ze-or/Taiplit20/README.md

# Taiplit20
20 key wireless split ergonomic keyboard
