ze-or/Taiplit20/PCB/PCB-Right/PCB-Right.kicad_pcb

## KiCad design PCB/PCB-Right/PCB-Right.kicad_pcb (2026-09-20)

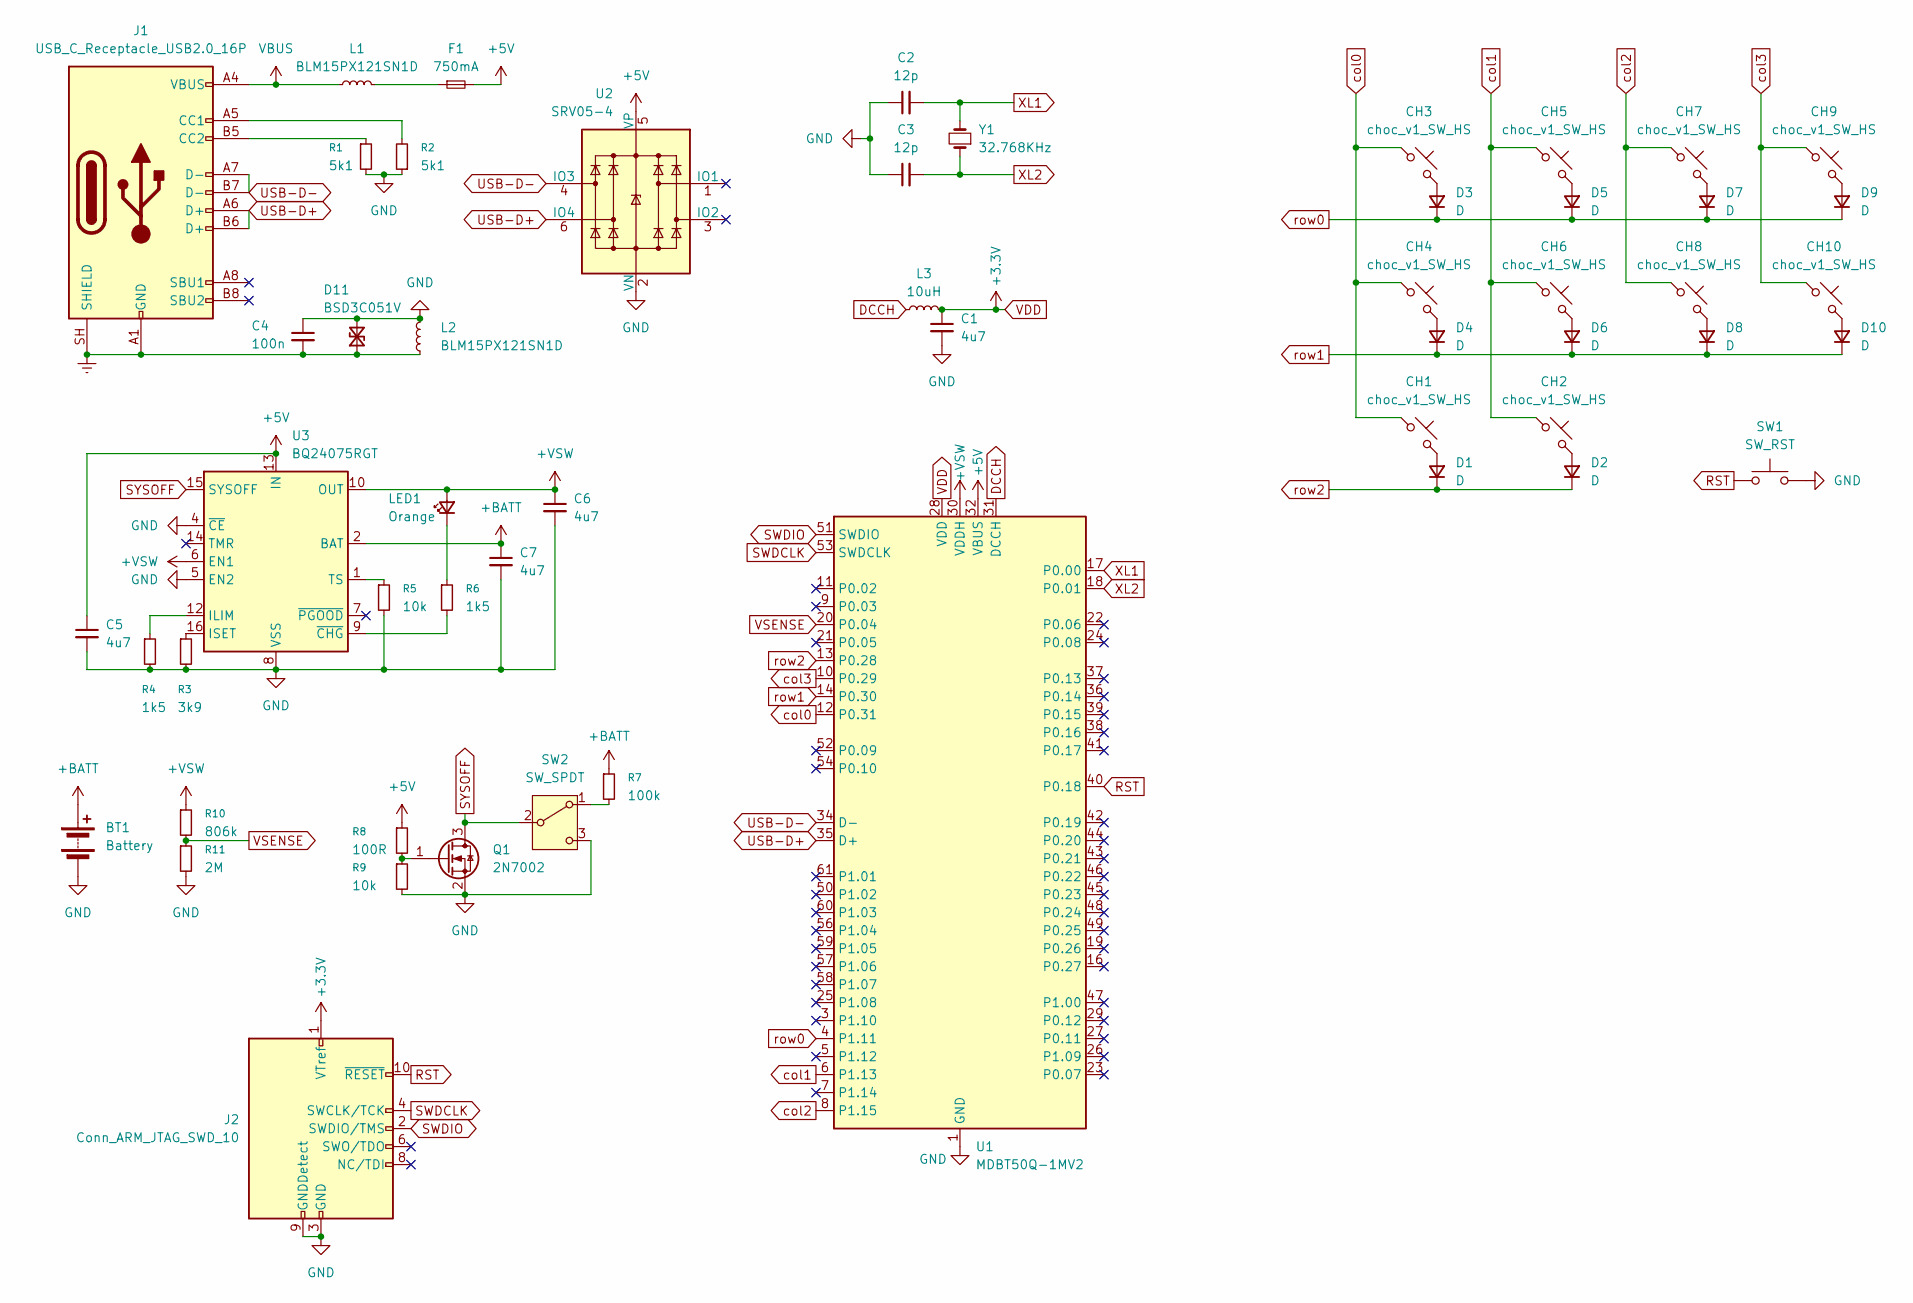
[picture p1: schematic PCB-Right.kicad_sch]

Parts:
BT1: Battery; JST_ACH_BM02B-ACHSS-GAN-ETF_1x02-1MP_P1.20mm_Vertical
C1, C5, C6, C7: 4u7; C_0603_1608Metric
C2, C3: 12p; C_0603_1608Metric
C4: 100n; C_0603_1608Metric
CH1, CH2, CH3, CH4, CH5, CH6, CH7, CH8, CH9, CH10: choc_v1_SW_HS; SW_choc_v2_HS_CPG135001S30_1u
D1, D2, D3, D4, D5, D6, D7, D8, D9, D10: D; D_SOD-123
D11: BSD3C051V; D_SOD-323
F1: 750mA; Fuse_1206_3216Metric
J1: USB_C_Receptacle_USB2.0_16P; USB_C_Receptacle_HRO_TYPE-C-31-M-12
J2: Conn_ARM_JTAG_SWD_10; PinHeader_2x05_P1.27mm_Vertical
L1, L2: BLM15PX121SN1D; L_0402_1005Metric
L3: 10uH; L_0603_1608Metric
LED1: Orange; LED_0805_2012Metric
Q1: 2N7002; SOT-23
R1, R2: 5k1; R_0603_1608Metric
R3: 3k9; R_0603_1608Metric
R4, R6: 1k5; R_0603_1608Metric
R5, R9: 10k; R_0603_1608Metric
R7: 100k; R_0603_1608Metric
R8: 100R; R_0603_1608Metric
R10: 806k; R_0603_1608Metric
R11: 2M; R_0603_1608Metric
SW1: SW_RST; SW_SPST_TL3342
SW2: SW_SPDT; SW_MSK12C02-HB
U1: MDBT50Q-1MV2; Raytac_MDBT50Q
U2: SRV05-4; SOT-23-6
U3: BQ24075RGT; VQFN-16-1EP_3x3mm_P0.5mm_EP1.6x1.6mm
Y1: 32.768KHz; Crystal_SMD_3215-2Pin_3.2x1.5mm

Connections:
+5V: C5.1, F1.2, R8.1, U1.32 (VBUS), U2.5 (VP), U3.13 (IN)
+BATT: BT1.1 (+), C7.1, R7.1, U3.2 (BAT), U3.3 (BAT)
+VSW: C6.1, LED1.2 (A), R10.1, U1.30 (VDDH), U3.6 (EN1), U3.10 (OUT), U3.11 (OUT)
DCCH: L3.1, U1.31 (DCCH)
Earth: C4.2, D11.1 (A1), J1.A1 (GND), J1.A12 (GND), J1.B1 (GND), J1.B12 (GND), J1.SH (SHIELD), L2.1
GND: BT1.2 (-), C1.2, C2.1, C3.1, C4.1, C5.2, C6.2, C7.2, D11.2 (A2), J2.3 (GND), J2.5 (GND), J2.9 (GNDDetect), L2.2, Q1.2 (S), R1.2, R2.1, R3.2, R4.2, R5.2, R9.2, R11.2, SW1.2, SW2.3 (C), U1.1 (GND), U1.2 (GND), U1.15 (GND), U1.33 (GND), U1.55 (GND), U2.2 (VN), U3.4 (~CE), U3.5 (EN2), U3.8 (VSS), U3.17 (VSS)
unnamed: CH1.2, D1.2 (A)
unnamed: CH2.2, D2.2 (A)
unnamed: CH3.2, D3.2 (A)
unnamed: CH4.2, D4.2 (A)
unnamed: CH5.2, D5.2 (A)
unnamed: CH6.2, D6.2 (A)
unnamed: CH7.2, D7.2 (A)
unnamed: CH8.2, D8.2 (A)
unnamed: CH9.2, D9.2 (A)
unnamed: CH10.2, D10.2 (A)
unnamed: F1.1, L1.2
unnamed: J1.A5 (CC1), R2.2
unnamed: J1.B5 (CC2), R1.1
unnamed: LED1.1 (K), R6.1
unnamed: Q1.1 (G), R8.2, R9.1
unnamed: R7.2, SW2.1 (A)
unnamed: R4.1, U3.12 (ILIM)
unnamed: R3.1, U3.16 (ISET)
unnamed: R5.1, U3.1 (TS)
unnamed: R6.2, U3.9 (~CHG)
RST: J2.10 (~RESET), SW1.1, U1.40 (P0.18)
SWDCLK: J2.4 (SWCLK/TCK), U1.53 (SWDCLK)
SWDIO: J2.2 (SWDIO/TMS), U1.51 (SWDIO)
SYSOFF: Q1.3 (D), SW2.2 (B), U3.15 (SYSOFF)
USB-D+: J1.A6 (D+), J1.B6 (D+), U1.35 (D+), U2.6 (IO4)
USB-D-: J1.A7 (D-), J1.B7 (D-), U1.34 (D-), U2.4 (IO3)
VBUS: J1.A4 (VBUS), J1.A9 (VBUS), J1.B4 (VBUS), J1.B9 (VBUS), L1.1
VDD: C1.1, J2.1 (VTref), L3.2, U1.28 (VDD)
VSENSE: R10.2, R11.1, U1.20 (P0.04)
XL1: C2.2, U1.17 (P0.00), Y1.2
XL2: C3.2, U1.18 (P0.01), Y1.1
col0: CH1.1, CH3.1, CH4.1, U1.12 (P0.31)
col1: CH2.1, CH5.1, CH6.1, U1.6 (P1.13)
col2: CH7.1, CH8.1, U1.8 (P1.15)
col3: CH9.1, CH10.1, U1.10 (P0.29)
row0: D3.1 (K), D5.1 (K), D7.1 (K), D9.1 (K), U1.4 (P1.11)
row1: D4.1 (K), D6.1 (K), D8.1 (K), D10.1 (K), U1.14 (P0.30)
row2: D1.1 (K), D2.1 (K), U1.13 (P0.28)

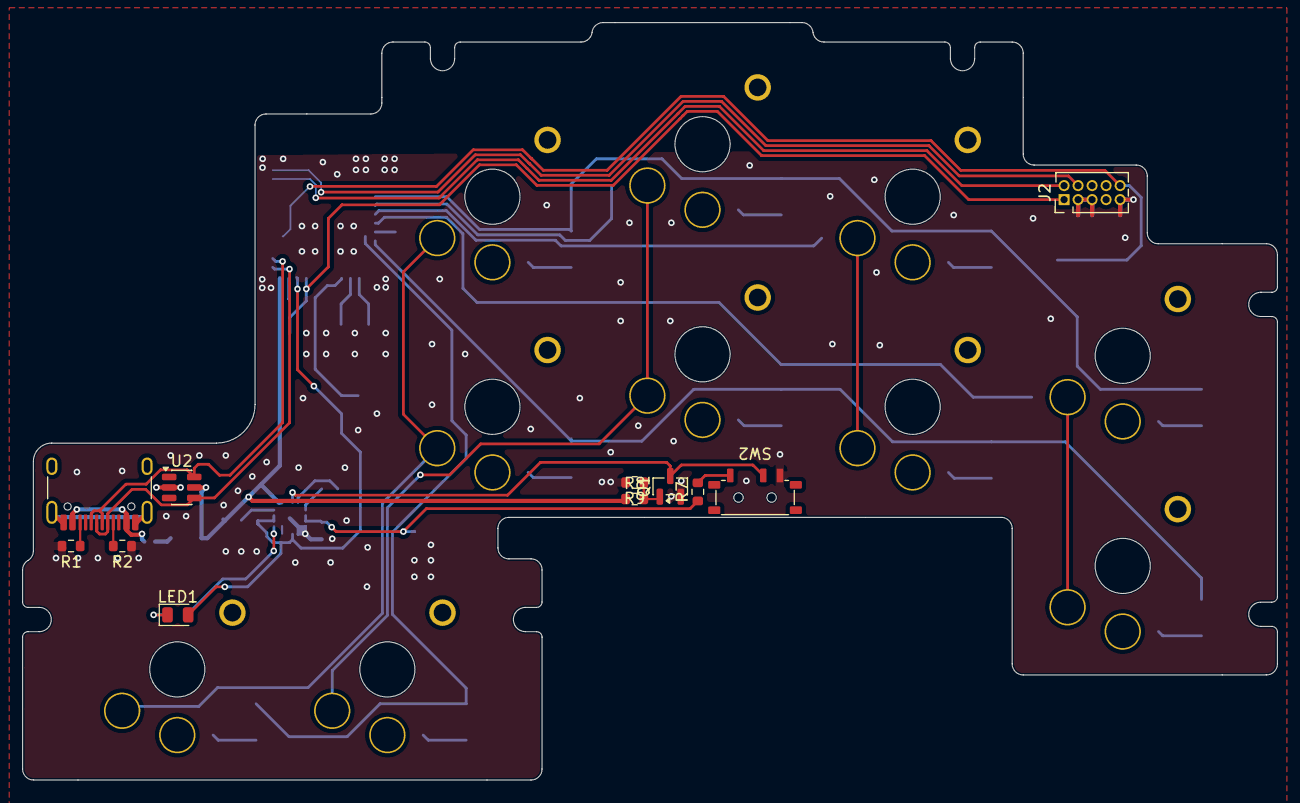
[picture p2: board PCB-Right.kicad_pcb from above]

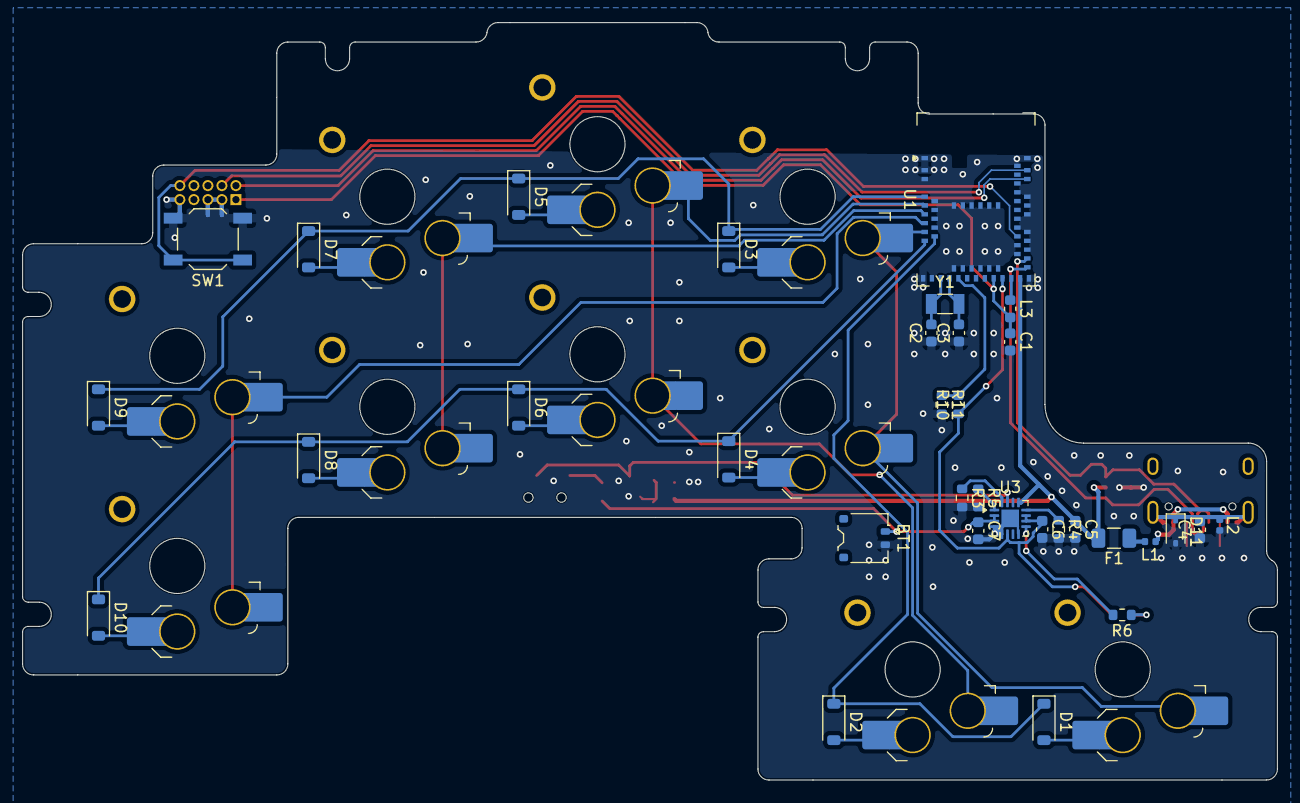
[picture p3: board PCB-Right.kicad_pcb from below]

Board: 2 copper layers, 113.8 x 68.7 mm, 54 parts (43 on the bottom side), 44 nets.
