ze-or/Taiplit20/(commit log)

2026-08-28 Initialize Kicad project
    [Taiplit20-pcb.kicad_pcb, Taiplit20-pcb.kicad_sch]
2026-08-29 Right PCB added
    [Taiplit20-pcb.kicad_pcb, Taiplit20-pcb.kicad_sch]
2026-09-02 Reorganize folders
    [ANT_Johanson_2450AT18D0100001E v1.step, CON_2082940020.step, CON_2082940030.step, CON_2082940040.step, CON_2082940050.step, CON_2121340002.step, CON_2121340003.step, CON_2121340004.step]
2026-09-20 PCB Right
    Switched to raytac module
    gasket mount
    [ANT_Johanson_2450AT18D0100001E v1.step, CON_2082940020.step, CON_2082940030.step, CON_2082940040.step, CON_2082940050.step, CON_2121340002.step, CON_2121340003.step, CON_2121340004.step]
2026-09-20 replace voltage regulator with DCCH inductor
    [PCB-Right.kicad_pcb, PCB-Right.kicad_sch]
2026-09-20 remove backup and lock files
    [PCB-Right.kicad_pcb, PCB-Right.kicad_sch]
